ginowup/RookBrilPCB/Project_Bestellijst.xlsx

Type | Component | Aantal | Mouser
L | VLCF5020T-100M1R1-1 | 1 | 810-VLCF52T100M1R11
L | DFE18SAN1R0ME0L | 1 | 81-DFE18SAN1R0ME0L
D | MBR0540 | 1 | 833-MBR0540L-TP
U | VNH7070ASTR | 1 | 511-VNH7070ASTR
U | TPS61170DRVR | 1 | 595-TPS61170DRVR
U | STM32F411RETx | 1 | 511-STM32F411RET6
 | TPS631000DRLR | 1 | 595-TPS631000DRLR
Y | ABM3-8.000MHZ-D2Y-T | 1 | 815-ABM3-8-D2Y-T
FB | 120R | 1 | 710-742792025
