ginowup/RookBrilPCB/CustomLibrary/3D_Files/VNH7070ASTR.stp

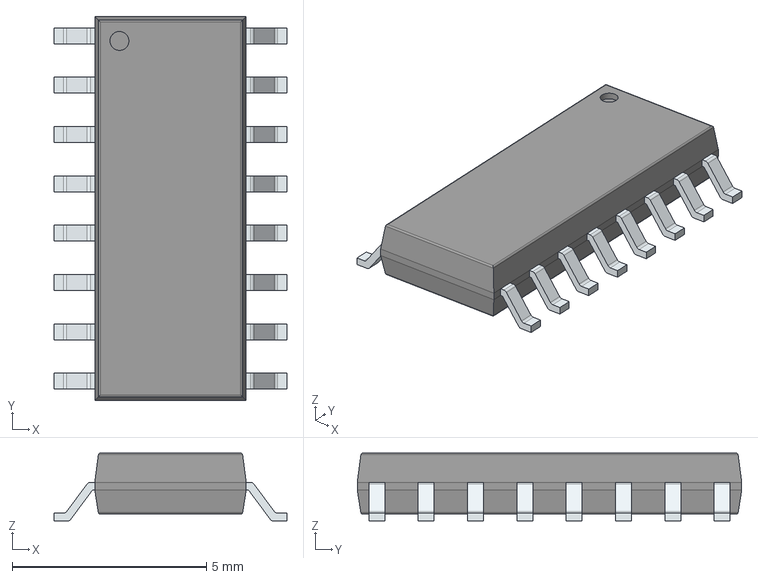
[picture p1: CAD file, 2023-10-11]
CustomLibrary/3D_Files/VNH7070ASTR.stp
6.00 x 9.90 x 1.75 mm
PinsArrayLR
