ginowup/RookBrilPCB/RookBril.kicad_pcb

## KiCad design RookBril.kicad_pcb (2023-11-28)

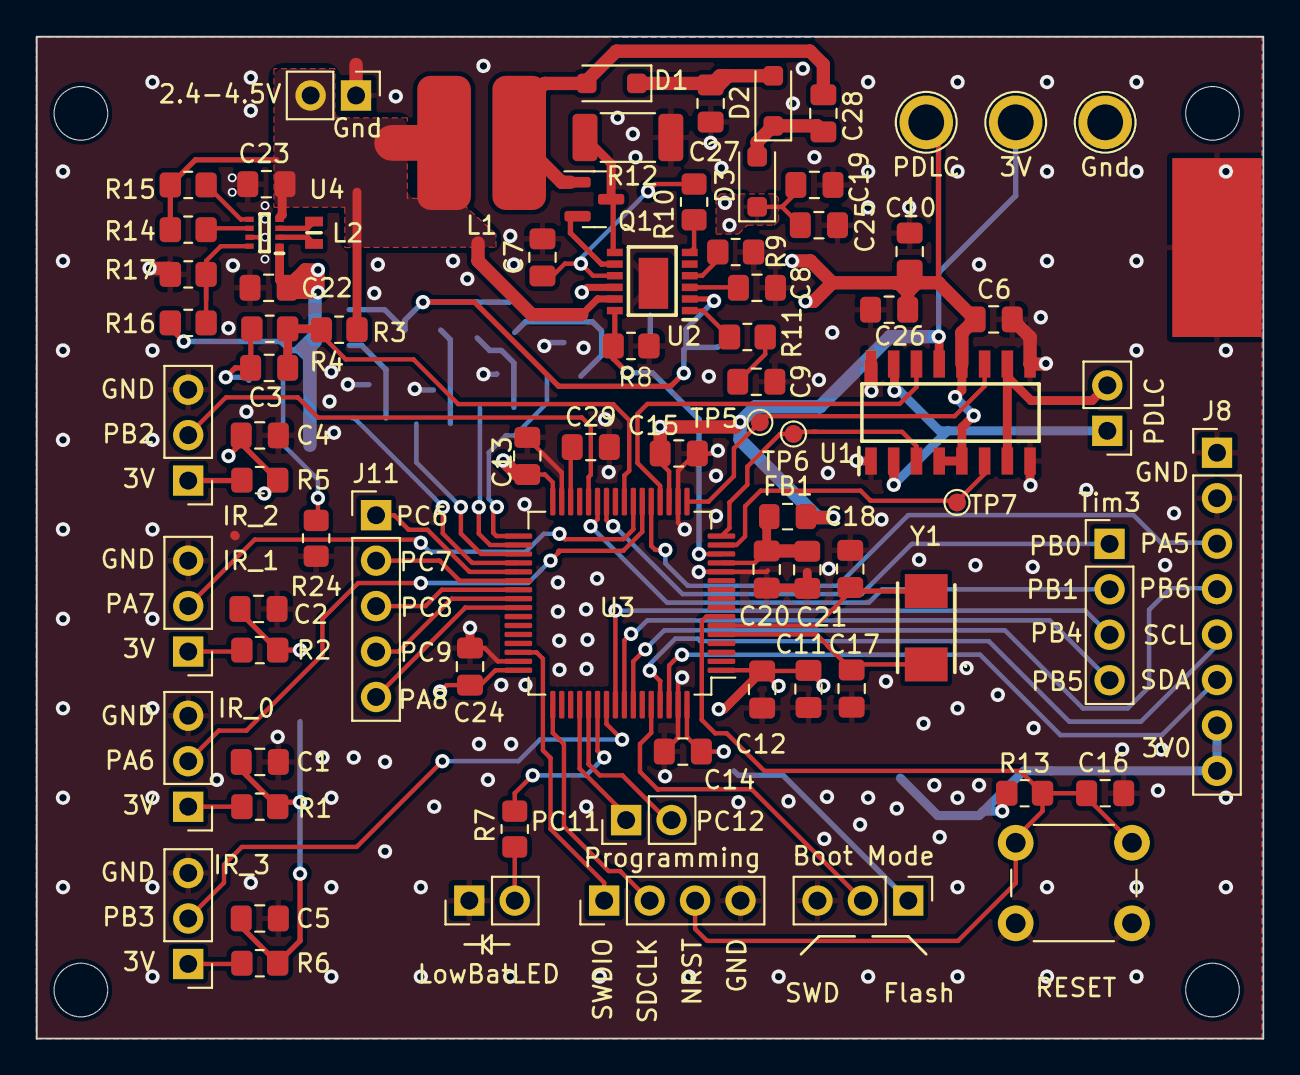
[picture p5: board RookBril.kicad_pcb from above]

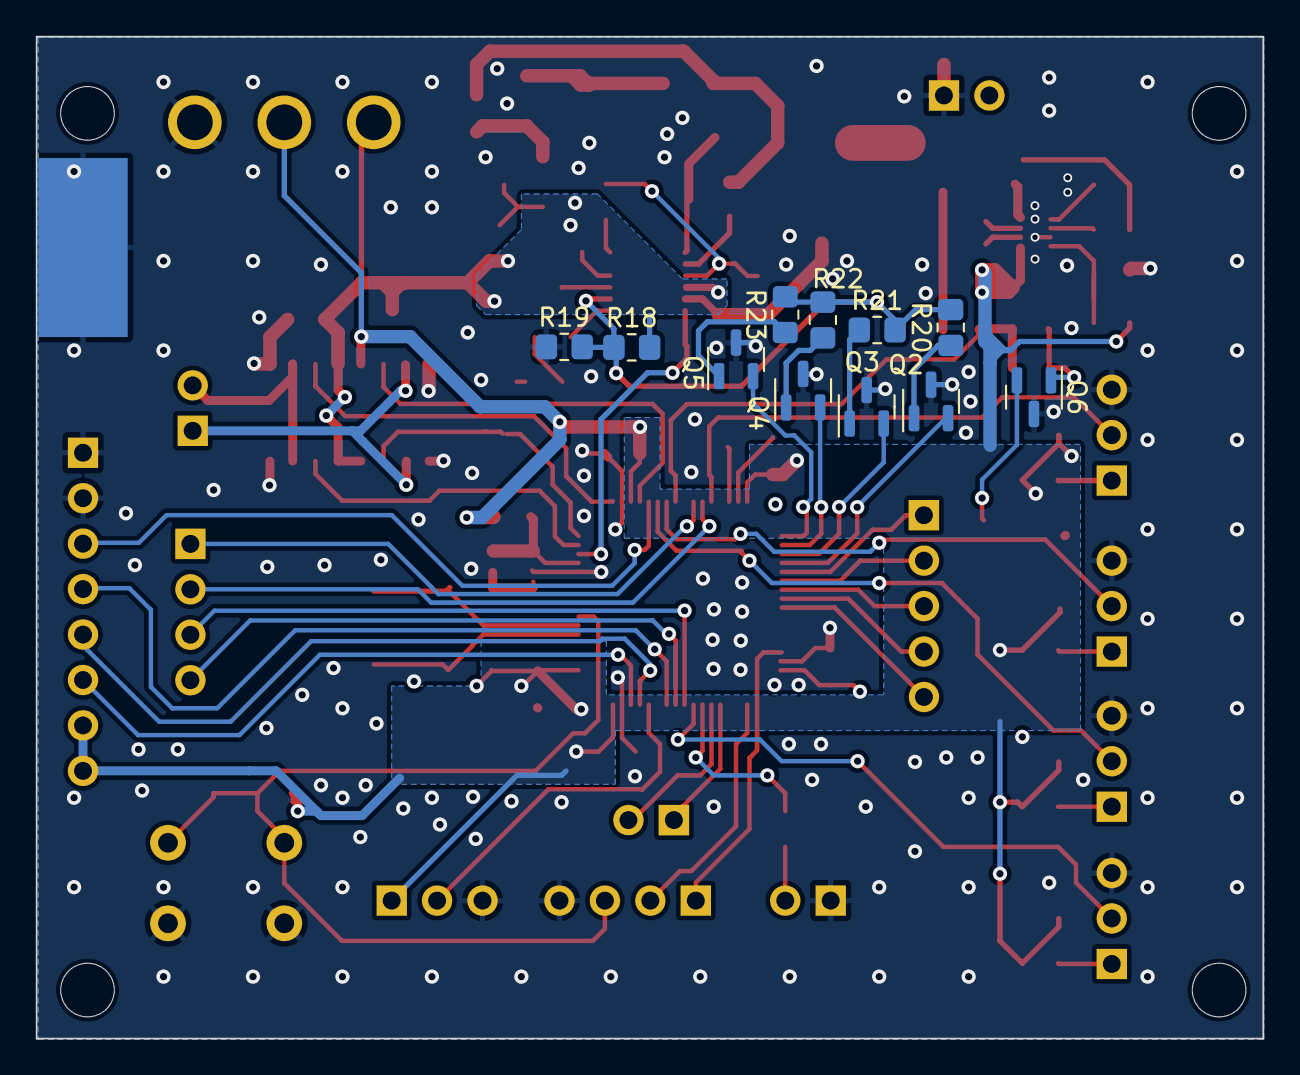
[picture p6: board RookBril.kicad_pcb from below]

Board: 2 copper layers, 68.6 x 56.0 mm, 95 parts (11 on the bottom side), 72 nets.

Parts:
C1, C2, C3, C4, C5, C6, C12, C13, C14, C15, C16, C24, C28: 100n; C_0805_2012Metric_Pad1.18x1.45mm_HandSolder
C7, C29: 4.7u; C_0805_2012Metric_Pad1.18x1.45mm_HandSolder
C8: 50n; C_0805_2012Metric_Pad1.18x1.45mm_HandSolder
C9: 22n; C_0805_2012Metric_Pad1.18x1.45mm_HandSolder
C10, C11, C19, C22, C23, C25, C26, C27: 10u; C_0805_2012Metric_Pad1.18x1.45mm_HandSolder
C17, C18: 26p; C_0805_2012Metric_Pad1.18x1.45mm_HandSolder
C20: 10n; C_0805_2012Metric_Pad1.18x1.45mm_HandSolder
C21: 1u; C_0805_2012Metric_Pad1.18x1.45mm_HandSolder
D1, D2, D3: D_SOD-123F
FB1: FerriteBead; L_0805_2012Metric_Pad1.15x1.40mm_HandSolder
H1, H2, H3, H4: MountingHole; MountingHole_3mm
J1: BATT_PINS; PinHeader_1x02_P2.54mm_Vertical
J2: IR_SENSOR0_PINS; PinHeader_1x03_P2.54mm_Vertical
J3: IR_SENSOR1_PINS; PinHeader_1x03_P2.54mm_Vertical
J4: IR_SENSOR2_PINS; PinHeader_1x03_P2.54mm_Vertical
J5: IR_SENSOR3_PINS; PinHeader_1x03_P2.54mm_Vertical
J6: LOW-BAT_LED_CONN; PinHeader_1x02_P2.54mm_Vertical
J7: PDLC_JST_PINS; PinHeader_1x02_P2.54mm_Vertical
J8: Conn_01x08_Pin; PinHeader_1x08_P2.54mm_Vertical
J9: MCU_MODE_PINS; PinHeader_1x03_P2.54mm_Vertical
J10: TIM3_OUT_CONN; PinHeader_1x04_P2.54mm_Vertical
J11: Conn_01x05_Pin; PinHeader_1x05_P2.54mm_Vertical
J12: Conn_01x04_Pin; PinHeader_1x04_P2.54mm_Vertical
J13: GPIO_OUT_CONN; PinHeader_1x02_P2.54mm_Vertical
L1: 10u; MRS8030T100
L2: DFE18SAN1R0ME0L
Q1, Q2, Q3, Q4, Q5, Q6: NMOS; SOT-23
R1, R2, R5, R6: R; R_0805_2012Metric_Pad1.20x1.40mm_HandSolder
R3: 51k; R_0805_2012Metric_Pad1.20x1.40mm_HandSolder
R4: 100K; R_0805_2012Metric_Pad1.20x1.40mm_HandSolder
R7: undetermined; R_0805_2012Metric_Pad1.20x1.40mm_HandSolder
R8: 118k; R_0805_2012Metric_Pad1.20x1.40mm_HandSolder
R9: 41.2k; R_0805_2012Metric_Pad1.20x1.40mm_HandSolder
R10, R14, R15: 100k; R_0805_2012Metric_Pad1.20x1.40mm_HandSolder
R11: 7.5k; R_0805_2012Metric_Pad1.20x1.40mm_HandSolder
R12: 5m; R_2010_5025Metric_Pad1.40x2.65mm_HandSolder
R13, R24: 10k; R_0805_2012Metric_Pad1.20x1.40mm_HandSolder
R16: 511k; R_0805_2012Metric_Pad1.20x1.40mm_HandSolder
R17: 91k; R_0805_2012Metric_Pad1.20x1.40mm_HandSolder
R18: 590k; R_0805_2012Metric_Pad1.20x1.40mm_HandSolder
R19: 47.6k; R_0805_2012Metric_Pad1.20x1.40mm_HandSolder
R20: 160k; R_0805_2012Metric_Pad1.20x1.40mm_HandSolder
R21: 80k; R_0805_2012Metric_Pad1.20x1.40mm_HandSolder
R22: 40k; R_0805_2012Metric_Pad1.20x1.40mm_HandSolder
R23: 20k; R_0805_2012Metric_Pad1.20x1.40mm_HandSolder
SW1: SW_Push; SW_PUSH_6mm_H5mm
TP1, TP2, TP4: TestPoint; TestPoint_Plated_Hole_D2.0mm
TP3: TestPoint; exposedPad5x10
TP5, TP6, TP7: TestPoint; TestPoint_Pad_D1.0mm
U1: VNH7070ASTR; SOIC127P600X175-16N
U2: LT3759
U3: STM32F411RETx; LQFP-64_10x10mm_P0.5mm
U4: TPS631000DRLR; SOTFL50P160X60-8N
Y1: ABM3-8.000MHZ-D2Y-T; ABM3

Connections:
+3V0: C1.1, C2.1, C4.1, C5.1, C11.1, C12.1, C13.1, C14.1, C15.1, C22.1, C24.1, FB1.1, J8.7, J8.8, J9.1, R1.1, R2.1, R5.1, R6.1, R13.1, R16.1, TP1.1, U1.13 (CS), U3.1 (VBAT), U3.19 (VDD), U3.32 (VDD), U3.48 (VDD), U3.64 (VDD), U4.1 (VOUT)
+BATT: C23.1, J1.2, L1.1, R3.1, R14.1, R15.2, U2.11 (Vin), U4.4 (VIN)
/H-BRIDGE_IN_A: TP6.1, U1.3 (IN_A), U3.16 (PA2)
/H-BRIDGE_IN_B: TP7.1, U1.6 (IN_B), U3.15 (PA1)
/H-BRIDGE_PWM: TP5.1, U1.11 (PWM), U3.17 (PA3)
/H-BRIDGE_SEL: U1.14 (SEL_0), U3.20 (PA4)
/IR_SIG0: J2.2, U3.22 (PA6)
/IR_SIG1: J3.2, U3.23 (PA7)
/IR_SIG2: J4.2, U3.28 (PB2)
/IR_SIG3: J5.2, U3.55 (PB3)
/MCU/HSE_IN: C17.1, U3.5 (PH0), Y1.1
/MCU/HSE_OUT: C18.1, U3.6 (PH1), Y1.2
/MCU/LOW-BAT_LED_EN: R7.1, U3.54 (PD2)
/MCU/NRST: C16.1, J12.3, R13.2, SW1.1, U3.7 (NRST)
/MCU/PA5: J8.3, U3.21 (PA5)
/MCU/PA8: J11.5, U3.41 (PA8)
/MCU/PB0: J10.1, U3.26 (PB0)
/MCU/PB1: J10.2, U3.27 (PB1)
/MCU/PB4: J10.3, U3.56 (PB4)
/MCU/PB5: J10.4, U3.57 (PB5)
/MCU/PB6: J8.4, U3.58 (PB6)
/MCU/PB8: J8.5, U3.61 (PB8)
/MCU/PB9: J8.6, U3.62 (PB9)
/MCU/PC6: J11.1, U3.37 (PC6)
/MCU/PC7: J11.2, U3.38 (PC7)
/MCU/PC8: J11.3, U3.39 (PC8)
/MCU/PC9: J11.4, U3.40 (PC9)
/MCU/PC11: J13.1, U3.52 (PC11)
/MCU/PC12: J13.2, U3.53 (PC12)
/MCU/SDCLK: J12.2, U3.49 (PA14)
/MCU/SWDIO: J12.1, U3.46 (PA13)
/PDLC-BOOST_VOUT-FBbit0: Q2.2 (G), U3.36 (PB15)
/PDLC-BOOST_VOUT-FBbit1: Q3.2 (G), U3.35 (PB14)
/PDLC-BOOST_VOUT-FBbit2: Q4.2 (G), U3.34 (PB13)
/PDLC-BOOST_VOUT-FBbit3: Q5.2 (G), U3.33 (PB12)
/PDLC-BOOST_VOut_EN: R8.1, U2.12 (EN/UVLO), U3.14 (PA0)
/VBAT_FB: C3.1, R3.2, R4.1, U3.24 (PC4)
/VBAT_Gate: Q6.2 (G), R24.1
GND: C1.2, C2.2, C4.2, C5.2, C6.2, C7.1, C8.1, C9.1, C10.1, C11.2, C12.2, C13.2, C14.2, C15.2, C16.2, C17.2, C18.2, C19.1, C20.2, C21.2, C22.2, C23.2, C24.2, C25.1, C26.1, C27.1, C29.2, J1.1, J2.3, J3.3, J4.3, J5.3, J6.1, J8.1, J8.2, J9.3, J12.4, Q2.3 (S), Q3.3 (S), Q4.3 (S), Q5.3 (S), Q6.3 (S), R8.2, R9.2, R12.1, R17.2, R19.1, R24.2, SW1.2, TP3.1, TP4.1, U1.1 (GND), U1.8 (GND), U1.9 (GND), U1.16 (GND), U2.13 (GND), U3.12 (VSSA), U3.18 (VSS), U3.31 (VSS), U3.47 (VSS), U3.63 (VSS), U4.7 (GND)
unnamed: C9.2, R11.1
unnamed: C28.2, D1.2 (A), L1.2, Q1.1 (D)
unnamed: C27.2, D1.1 (K), D2.2 (A)
unnamed: C28.1, D2.1 (K), D3.2 (A)
unnamed: J2.1, R1.2
unnamed: J3.1, R2.2
unnamed: J4.1, R5.2
unnamed: J5.1, R6.2
unnamed: J6.2, R7.2
unnamed: J7.1, U1.2 (OUT_A), U1.15 (OUT_A)
unnamed: J7.2, U1.7 (OUT_B), U1.10 (OUT_B)
unnamed: J9.2, U3.60 (BOOT0)
unnamed: Q1.2 (G), U2.8 (GATE)
unnamed: Q1.3 (S), R12.2, U2.7 (SENSE)
unnamed: Q2.1 (D), R20.1
unnamed: Q3.1 (D), R21.1
unnamed: Q4.1 (D), R22.1
unnamed: Q5.1 (D), R23.1
unnamed: C3.2, Q6.1 (D), R4.2
unnamed: R18.1, R19.2, R20.2, R21.2, R22.2, R23.2, U2.2 (FBX)
unnamed: C7.2, R10.1, U2.9 (INTVcc)
unnamed: R10.2, U2.6 (PGOOD)
unnamed: R9.1, U2.4 (RT)
unnamed: C8.2, U2.3 (SS)
unnamed: R11.2, U2.1 (Vc)
unnamed: C29.1, U3.30 (VCAP1)
unnamed: R15.1, U4.5 (EN)
unnamed: R16.2, R17.1, U4.8 (FB)
unnamed: L2.1, U4.3 (LX1)
unnamed: L2.2, U4.2 (LX2)
unnamed: R14.2, U4.6 (MODE)
VCC: C6.1, C10.2, C19.2, C25.2, C26.2, D3.1 (K), R18.2, TP2.1, U1.4 (VCC), U1.5 (VCC), U1.12 (VCC), U2.10 (DRIVE)
VDDA: C20.1, C21.1, FB1.2, U3.13 (VDDA)
