ginowup/RookBrilPCB/(commit log)

2023-10-11 Started Project, added PDLC and the boost ic
    [RookBril.kicad_pcb, RookBril.kicad_sch, TPS61170DRVR.stp, VNH7070ASTR.stp, power.kicad_sch]
2023-10-12 Buffed the diode, changed compensation components
    [power.kicad_sch]
2023-10-12 updated schematic
    alles toegevoegd aan de schematic
    [3V_BUCK-BOOST.kicad_sch, RookBril.kicad_sch, power.kicad_sch, untitled.kicad_sch]
2023-10-13 footprint assignments gedaan + verbeteringen
    [3V_BUCK-BOOST.kicad_sch, MCU.kicad_sch, RookBril.kicad_sch, power.kicad_sch]
2023-10-13 aantal componenten veranderd.
    [3V_BUCK-BOOST.kicad_sch, MCU.kicad_sch, RookBril.kicad_pcb, RookBril.kicad_sch, power.kicad_sch]
2023-10-13 beginsel aan pcb gemaakt
    [MCU.kicad_sch, RookBril.kicad_pcb]
2023-10-16 Alle verbindingen gelegt van de componenten.
    Moet nog bij nog tekst bij de connectoren zetten. Ook zijn de unconnected pinnen weggehaald, omdat het onmogelijk maakt voor een 2 laags PCB.
    [MCU.kicad_sch, RookBril.kicad_pcb]
2023-10-17 nieuwe layout
    [MCU.kicad_sch, RookBril.kicad_pcb, power.kicad_sch]
2023-10-18 bijna alle verbindingen gelegd
    [RookBril.kicad_pcb]
2023-10-18 Alles klaar 1 error, en nog silkscreen fixen
    [RookBril.kicad_pcb]
2023-10-20 Klein beetje reorganiseren van de lay-out Silkscreen schoongemaakt TestPoints en Mounting holes toegevoegd
    [RookBril.kicad_pcb, RookBril.kicad_sch]
2023-10-20 Kleine veranderingen gebaseerd op feedback whatsapp
    [3V_BUCK-BOOST.kicad_sch, MCU.kicad_sch, RookBril.kicad_pcb]
2023-10-20 updated schematic en interactive bom in de git
    [MCU.kicad_sch, RookBril.kicad_sch]
2023-10-20 Production files for JLC with the addon
    [Project_Bestellijst.xlsx]
2023-11-03 kleine dingen
    [RookBril.kicad_sch]
2023-11-26 NieuwePDLCVoedingen
    -LT1308
    -LT3759
    -Mixed schematic
    -Mixed footprints
    [power.kicad_sch]
2023-11-27 PCBv2.01
    Eerste versie van de tweede versie van de pcb prototype.
    Nieuwe PDLC voeding, extra pinnen beschikbaar voor GUI inclusief voeding pinnen.
    [3V_BUCK-BOOST.kicad_sch, MCU.kicad_sch, RookBril.kicad_pcb, RookBril.kicad_sch, power.kicad_sch]
2023-11-28 PCBv2.02
    Toepassingen van wouters feedback.
    Condensatoren beter geplaatst bij pdlc, mosfet toegevoegd bij fb bat, extra vias toegevoegd en traces verschoven voor betere GND plane connecties
    [MCU.kicad_sch, RookBril.kicad_pcb, RookBril.kicad_sch]
2023-11-28 Paar kleine veranderingen, ziet er mooi uit
    [MCU.kicad_sch, RookBril.kicad_pcb, RookBril.kicad_sch, power.kicad_sch]
